djtersteegc/Coco-FujiNet/README.md

Find all the CocoFuji needs in the main Fujinet hardware repo now, https://github.com/FujiNetWIFI/fujinet-hardware
