djtersteegc/Coco-FujiNet/CoCo-FujiNet-Rev000/3D/STL/CoCo-FujiNet-Rev000-Upper.stl

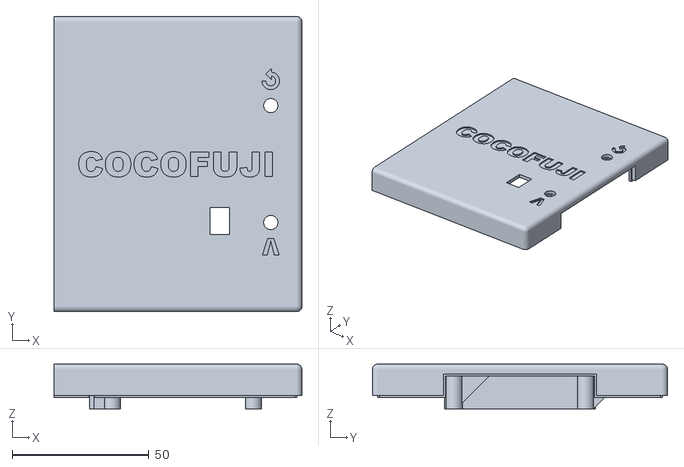
[picture p1: CAD file, 2024-03-17, last stored version]
CoCo-FujiNet-Rev000/3D/STL/CoCo-FujiNet-Rev000-Upper.stl
90.7 x 108.0 x 16.4
