djtersteegc/Coco-FujiNet/CoCo-FujiNet-Rev000/3D/STL/CoCo-FujiNet-Rev000-Lower.stl

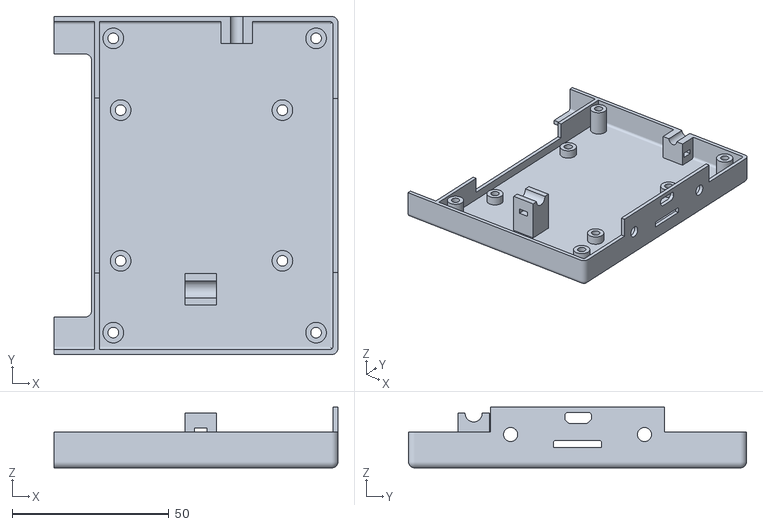
[picture p2: CAD file, 2024-03-17, last stored version]
CoCo-FujiNet-Rev000/3D/STL/CoCo-FujiNet-Rev000-Lower.stl
90.7 x 108.0 x 19.4
