djtersteegc/Coco-FujiNet/CoCo-FujiNet-Rev000/3D/STL/CoCo-FujiNet-Rev000-4mm-Spacer.stl

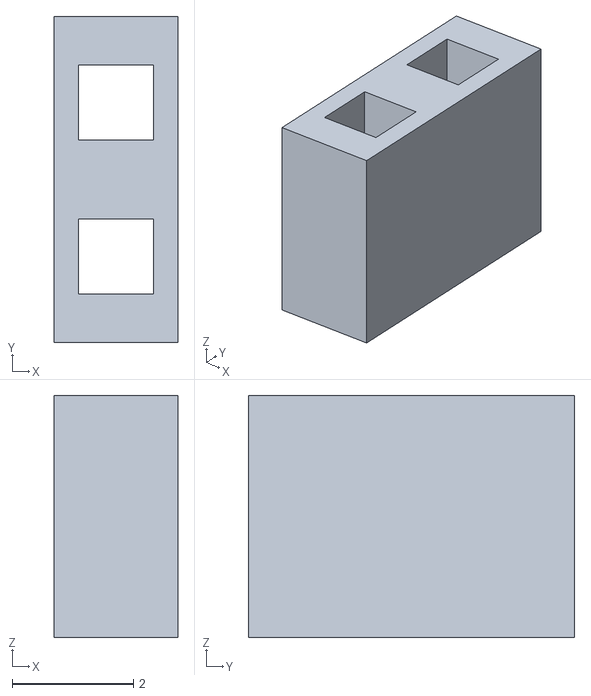
[picture p3: CAD file, 2024-03-04, last stored version]
CoCo-FujiNet-Rev000/3D/STL/CoCo-FujiNet-Rev000-4mm-Spacer.stl
2.04 x 5.38 x 4.00
