djtersteegc/Coco-FujiNet/CoCo-FujiNet-Rev000/CoCo-FujiNet-Rev000.kicad_pcb

## KiCad design CoCo-FujiNet-Rev000/CoCo-FujiNet-Rev000.kicad_pcb (2024-03-04, last stored version)

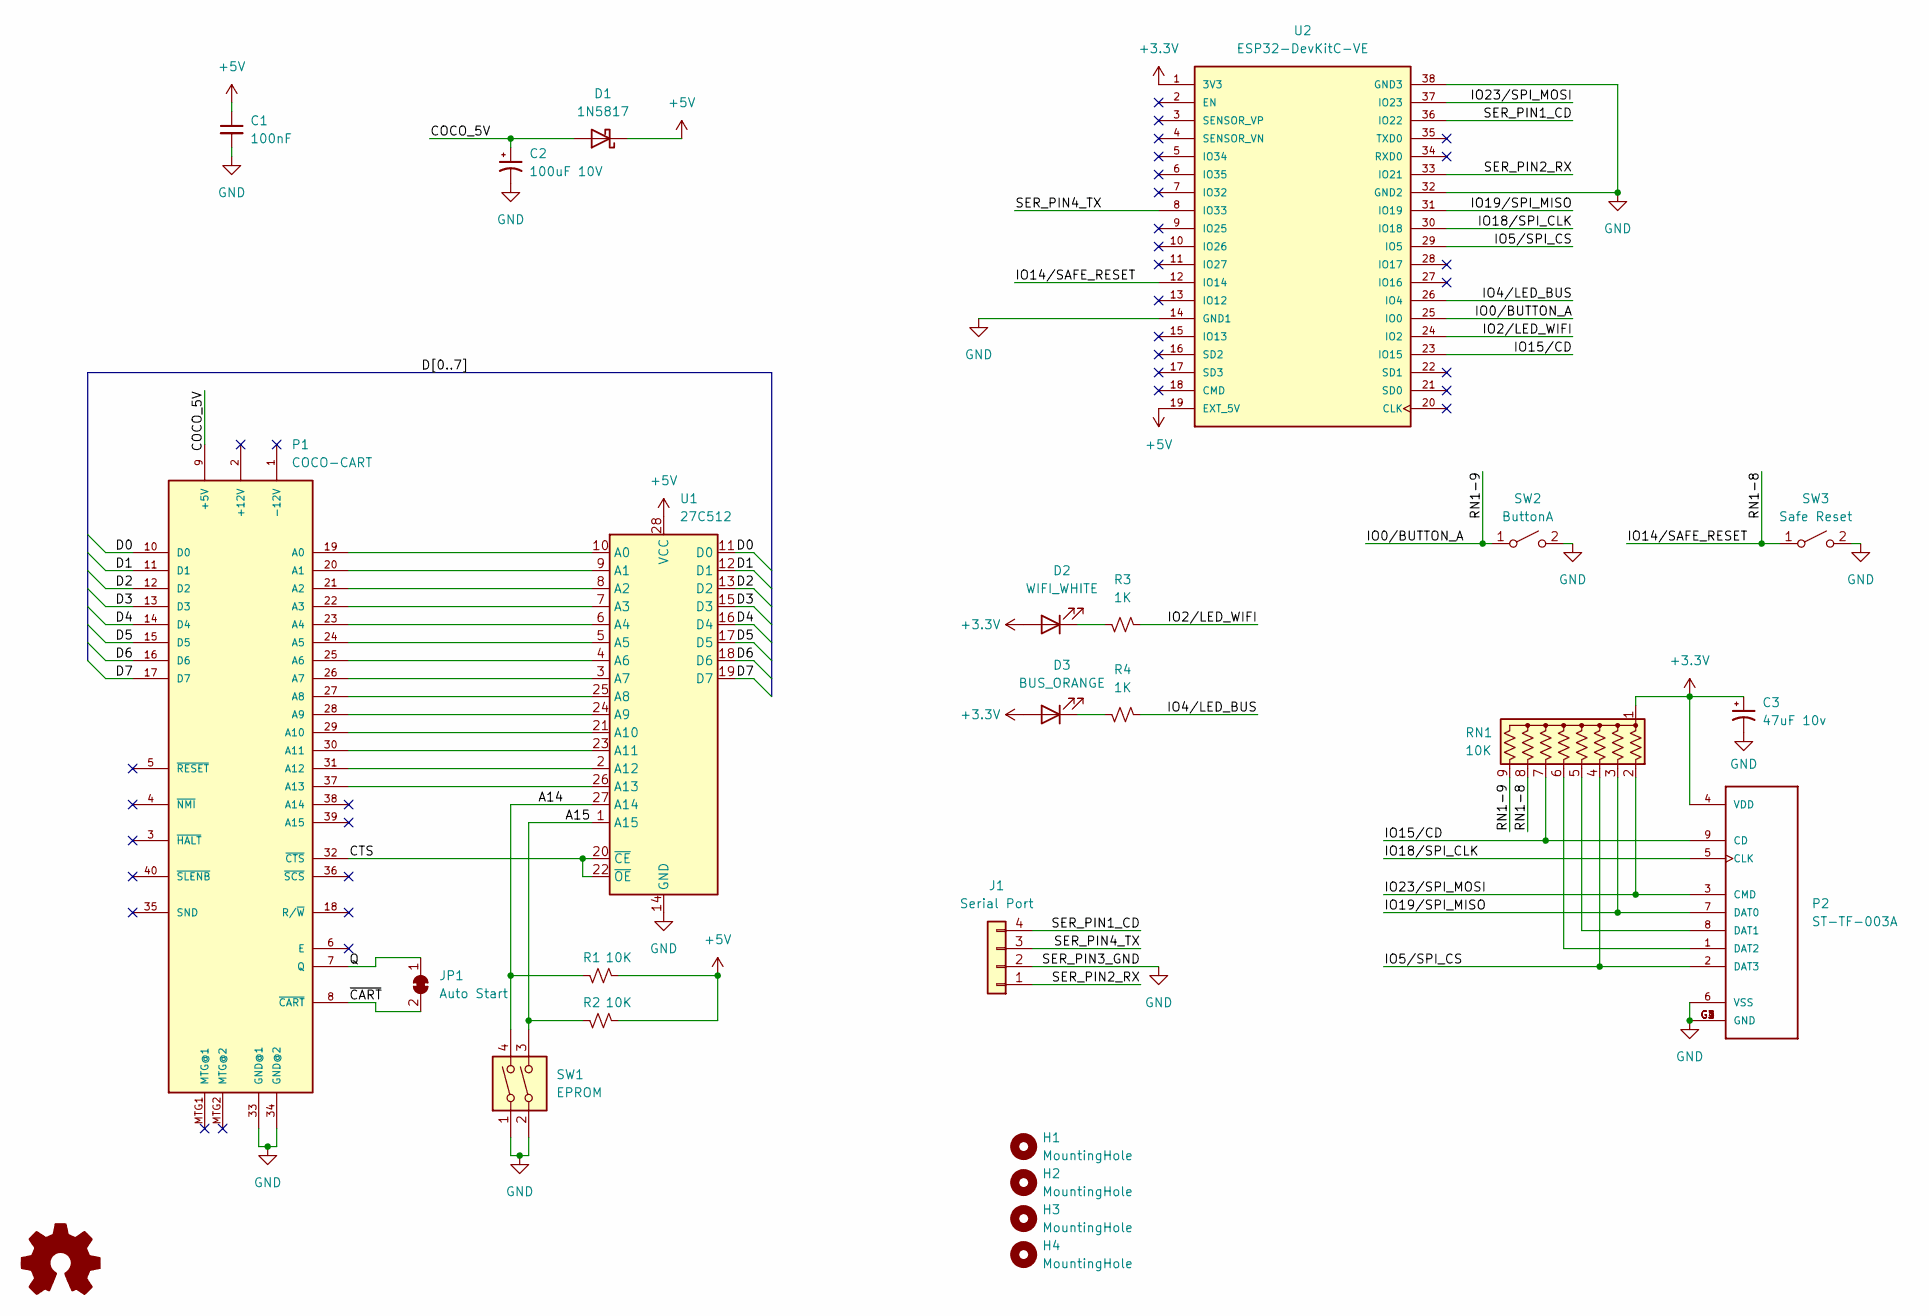
[picture p4: schematic CoCo-FujiNet-Rev000.kicad_sch, CoCo FujiNet]

Parts:
C1: 100nF; C_Disc_D4.7mm_W2.5mm_P5.00mm
C2: 100uF 10V; CP_Radial_D6.3mm_P2.50mm
C3: 47uF 10v; CP_EIA-3528-15_AVX-H_Pad1.50x2.35mm_HandSolder
D1: 1N5817; D_DO-41_SOD81_P10.16mm_Horizontal
D2: WIFI_WHITE; LED_D3.0mm
D3: BUS_ORANGE; LED_D3.0mm
H1, H2, H3, H4: MountingHole; MountingHole_3.2mm_M3
J1: Serial Port; PinHeader_1x04_P2.54mm_Vertical
JP1: Auto Start; SolderJumper-2_P1.3mm_Bridged_RoundedPad1.0x1.5mm
P1: COCO-CART
P2: ST-TF-003A; SUNTECH_ST-TF-003A
R1, R2: 10K; R_Axial_DIN0207_L6.3mm_D2.5mm_P7.62mm_Horizontal
R3, R4: 1K; R_Axial_DIN0207_L6.3mm_D2.5mm_P7.62mm_Horizontal
RN1: 10K; R_Array_SIP9
SW1: EPROM; SW_DIP_SPSTx02_Slide_9.78x7.26mm_W7.62mm_P2.54mm
SW2: ButtonA; SW_Tactile_SPST_Angled_PTS645Vx58-2LFS
SW3: Safe Reset; SW_Tactile_SPST_Angled_PTS645Vx58-2LFS
U1: 27C512; DIP-28_W15.24mm
U2: ESP32-DevKitC-VE; MODULE_ESP32-DEVKITC-32U; PARTREV N/A

Connections:
+3.3V: C3.1, D2.2 (A), D3.2 (A), P2.4 (VDD), RN1.1 (common), U2.1 (3V3)
+5V: C1.1, D1.1 (K), R1.2, R2.2, U1.28 (VCC), U2.19 (EXT_5V)
/A14: R1.1, SW1.4, U1.27 (A14)
/A15: R2.1, SW1.3, U1.1 (A15)
/COCO_5V: C2.1, D1.2 (A), P1.9 (+5V)
/CTS: P1.32 (~CTS), U1.20 (~CE), U1.22 (~OE)
/D0: P1.10 (D0), U1.11 (D0)
/D1: P1.11 (D1), U1.12 (D1)
/D2: P1.12 (D2), U1.13 (D2)
/D3: P1.13 (D3), U1.15 (D3)
/D4: P1.14 (D4), U1.16 (D4)
/D5: P1.15 (D5), U1.17 (D5)
/D6: P1.16 (D6), U1.18 (D6)
/D7: P1.17 (D7), U1.19 (D7)
/IO0/BUTTON_A: RN1.9 (R8), SW2.1 (A), U2.25 (IO0)
/IO2/LED_WIFI: R3.2, U2.24 (IO2)
/IO4/LED_BUS: R4.2, U2.26 (IO4)
/IO5/SPI_CS: P2.2 (DAT3), RN1.4 (R3), U2.29 (IO5)
/IO14/SAFE_RESET: RN1.8 (R7), SW3.1 (A), U2.12 (IO14)
/IO15/CD: P2.9 (CD), RN1.7 (R6), U2.23 (IO15)
/IO18/SPI_CLK: P2.5 (CLK), U2.30 (IO18)
/IO19/SPI_MISO: P2.7 (DAT0), RN1.3 (R2), U2.31 (IO19)
/IO23/SPI_MOSI: P2.3 (CMD), RN1.2 (R1), U2.37 (IO23)
/Q: JP1.1 (A), P1.7 (Q)
/SER_PIN1_CD: J1.4, U2.36 (IO22)
/SER_PIN2_RX: J1.1, U2.33 (IO21)
/SER_PIN4_TX: J1.3, U2.8 (IO33)
/~CART: JP1.2 (B), P1.8 (~CART)
GND: C1.2, C2.2, C3.2, J1.2, P1.33 (GND@1), P1.34 (GND@2), P2.6 (VSS), P2.G1 (GND), P2.G2 (GND), P2.G3 (GND), P2.G4 (GND), SW1.1, SW1.2, SW2.2 (B), SW3.2 (B), U1.14 (GND), U2.14 (GND1), U2.32 (GND2), U2.38 (GND3)
unnamed: D2.1 (K), R3.1
unnamed: D3.1 (K), R4.1
unnamed: P1.19 (A0), U1.10 (A0)
unnamed: P1.20 (A1), U1.9 (A1)
unnamed: P1.21 (A2), U1.8 (A2)
unnamed: P1.22 (A3), U1.7 (A3)
unnamed: P1.23 (A4), U1.6 (A4)
unnamed: P1.24 (A5), U1.5 (A5)
unnamed: P1.25 (A6), U1.4 (A6)
unnamed: P1.26 (A7), U1.3 (A7)
unnamed: P1.27 (A8), U1.25 (A8)
unnamed: P1.28 (A9), U1.24 (A9)
unnamed: P1.29 (A10), U1.21 (A10)
unnamed: P1.30 (A11), U1.23 (A11)
unnamed: P1.31 (A12), U1.2 (A12)
unnamed: P1.37 (A13), U1.26 (A13)
unnamed: P2.8 (DAT1), RN1.5 (R4)
unnamed: P2.1 (DAT2), RN1.6 (R5)

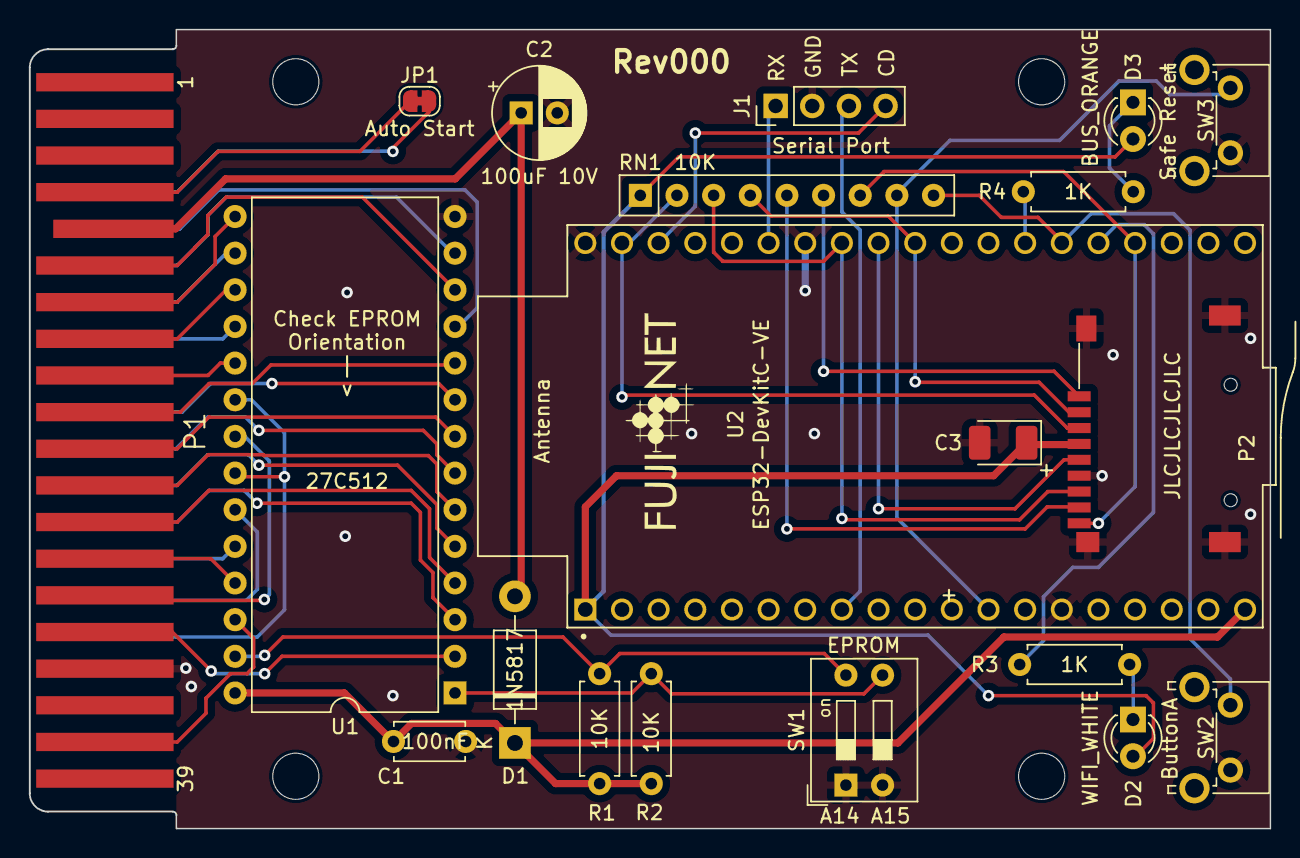
[picture p5: board CoCo-FujiNet-Rev000.kicad_pcb from above]

Board: 2 copper layers, 86.0 x 55.4 mm, 24 parts (0 on the bottom side), 47 nets.
