djtersteegc/Coco-FujiNet/CoCo-FujiNet-Rev00/CoCo-FujiNet-Rev00.kicad_pcb

## KiCad design CoCo-FujiNet-Rev00/CoCo-FujiNet-Rev00.kicad_pcb (2024-01-20, last stored version)

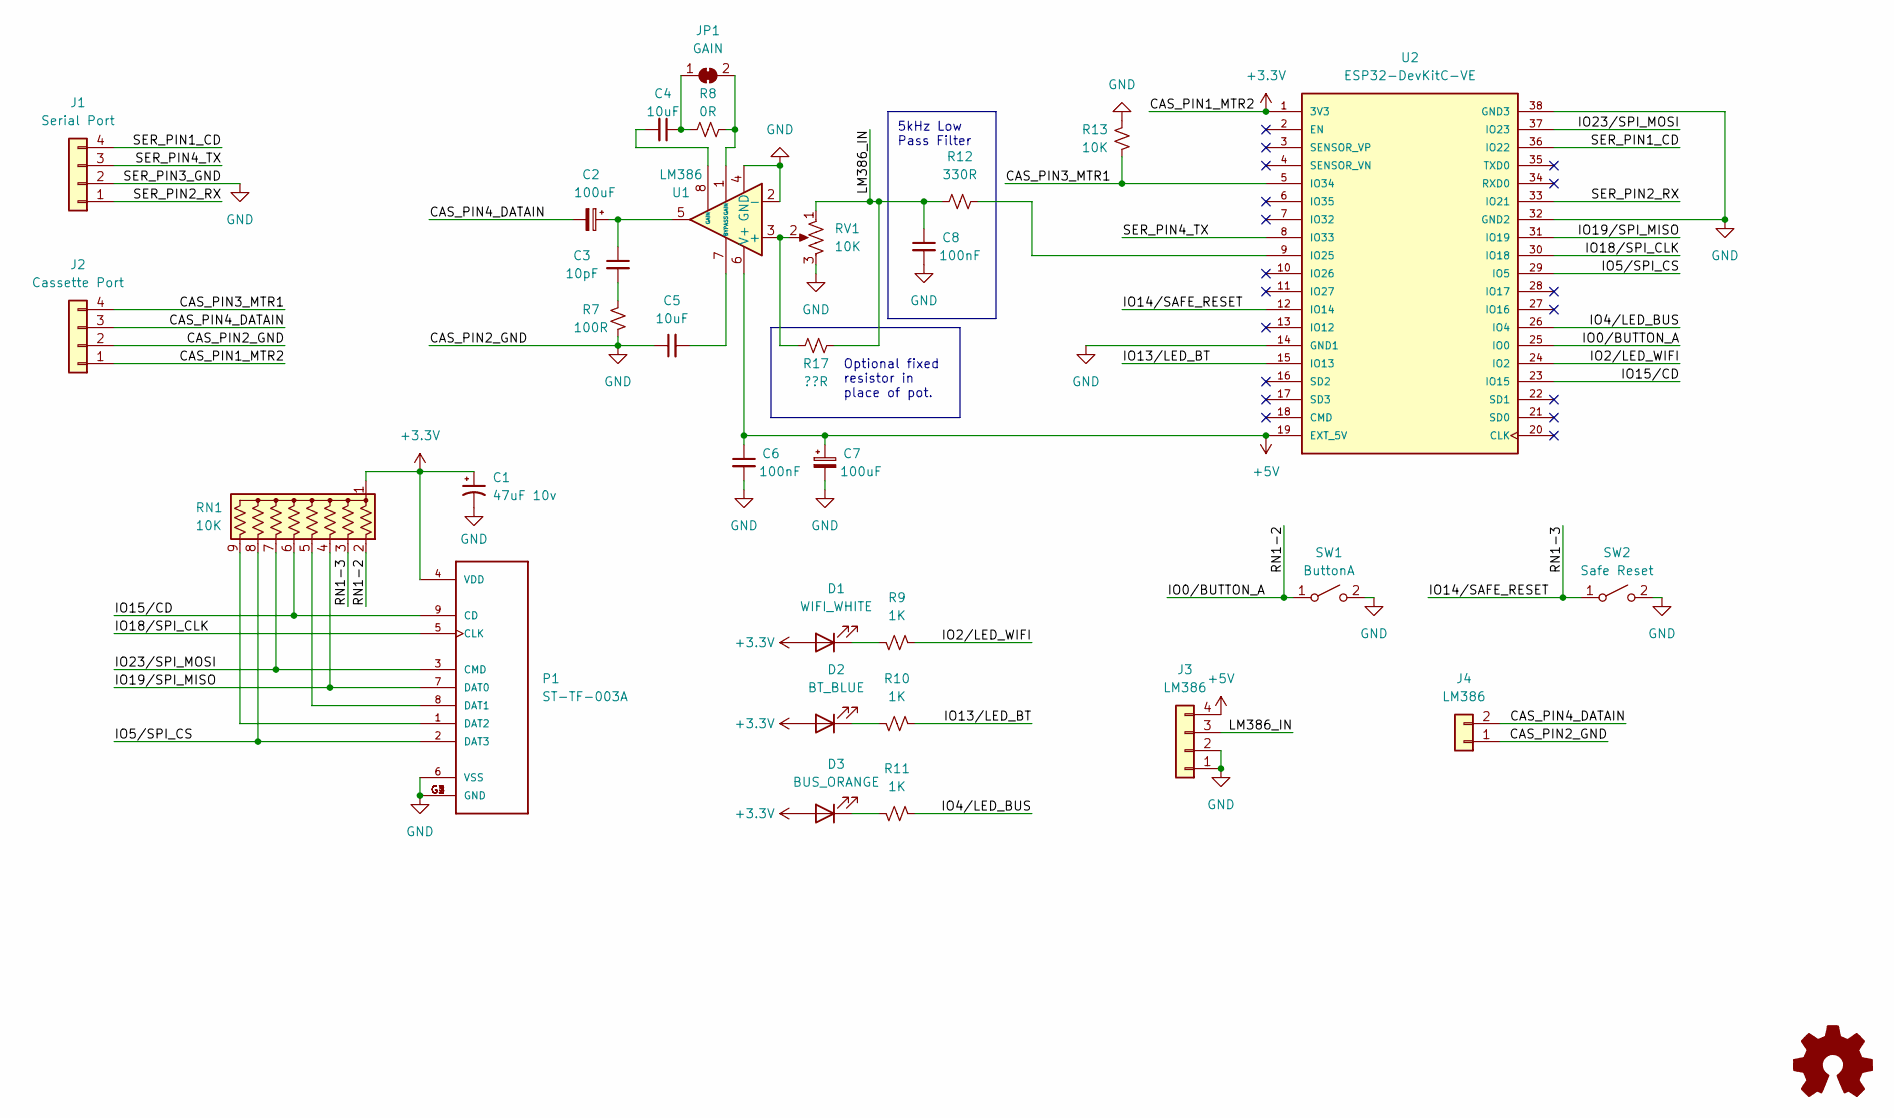
[picture p6: schematic CoCo-FujiNet-Rev00.kicad_sch, CoCo FujiNet]

Parts:
C1: 47uF 10v; CP_EIA-3528-15_AVX-H_Pad1.50x2.35mm_HandSolder
C2, C7: 100uF; CP_Radial_D6.3mm_P2.50mm
C3: 10pF; C_Disc_D5.0mm_W2.5mm_P5.00mm
C4, C5: 10uF; C_Disc_D5.0mm_W2.5mm_P5.00mm
C6, C8: 100nF; C_Disc_D5.0mm_W2.5mm_P5.00mm
D1: WIFI_WHITE; LED_D3.0mm
D2: BT_BLUE; LED_D3.0mm
D3: BUS_ORANGE; LED_D3.0mm
J1: Serial Port; PinHeader_1x04_P2.54mm_Vertical
J2: Cassette Port; PinHeader_1x04_P2.54mm_Vertical
J3: LM386; PinHeader_1x04_P2.54mm_Vertical
J4: LM386; PinHeader_1x02_P2.54mm_Vertical
JP1: GAIN; SolderJumper-2_P1.3mm_Bridged_RoundedPad1.0x1.5mm
P1: ST-TF-003A; SUNTECH_ST-TF-003A
R7: 100R; R_Axial_DIN0207_L6.3mm_D2.5mm_P7.62mm_Horizontal
R8: 0R; R_Axial_DIN0207_L6.3mm_D2.5mm_P7.62mm_Horizontal
R9, R10, R11: 1K; R_Axial_DIN0207_L6.3mm_D2.5mm_P7.62mm_Horizontal
R12: 330R; R_Axial_DIN0207_L6.3mm_D2.5mm_P7.62mm_Horizontal
R13: 10K; R_Axial_DIN0207_L6.3mm_D2.5mm_P7.62mm_Horizontal
R17: ??R; R_Axial_DIN0207_L6.3mm_D2.5mm_P7.62mm_Horizontal
RN1: 10K; R_Array_SIP9
RV1: 10K; Potentiometer_Runtron_RM-065_Vertical
SW1: ButtonA; SW_PUSH_6mm_H5mm
SW2: Safe Reset; SW_PUSH_6mm_H5mm
U1: LM386; DIP-8_W7.62mm_Socket
U2: ESP32-DevKitC-VE; MODULE_ESP32-DEVKITC-32U; PARTREV N/A

Connections:
+3.3V: C1.1, D1.2 (A), D2.2 (A), D3.2 (A), J2.1, P1.4 (VDD), RN1.1 (common), U2.1 (3V3)
+5V: C6.1, C7.1, J3.4, U1.6 (V+), U2.19 (EXT_5V)
/CAS_PIN3_MTR1: J2.4, R13.1, U2.5 (IO34)
/CAS_PIN4_DATAIN: C2.2, J2.3, J4.2
/IO0/BUTTON_A: RN1.2 (R1), SW1.1 (A), U2.25 (IO0)
/IO2/LED_WIFI: R9.2, U2.24 (IO2)
/IO4/LED_BUS: R11.2, U2.26 (IO4)
/IO5/SPI_CS: P1.2 (DAT3), RN1.8 (R7), U2.29 (IO5)
/IO13/LED_BT: R10.2, U2.15 (IO13)
/IO14/SAFE_RESET: RN1.3 (R2), SW2.1 (A), U2.12 (IO14)
/IO15/CD: P1.9 (CD), RN1.6 (R5), U2.23 (IO15)
/IO18/SPI_CLK: P1.5 (CLK), U2.30 (IO18)
/IO19/SPI_MISO: P1.7 (DAT0), RN1.4 (R3), U2.31 (IO19)
/IO23/SPI_MOSI: P1.3 (CMD), RN1.7 (R6), U2.37 (IO23)
/LM386_IN: C8.1, J3.3, R12.1, R17.2, RV1.1
/SER_PIN1_CD: J1.4, U2.36 (IO22)
/SER_PIN2_RX: J1.1, U2.33 (IO21)
/SER_PIN4_TX: J1.3, U2.8 (IO33)
GND: C1.2, C5.1, C6.2, C7.2, C8.2, J1.2, J2.2, J3.1, J3.2, J4.1, P1.6 (VSS), P1.G1 (GND), P1.G2 (GND), P1.G3 (GND), P1.G4 (GND), R7.1, R13.2, RV1.3, SW1.2 (B), SW2.2 (B), U1.2 (-), U1.4 (GND), U2.14 (GND1), U2.32 (GND2), U2.38 (GND3)
unnamed: C2.1, C3.1, U1.5
unnamed: C3.2, R7.2
unnamed: C4.2, U1.8 (GAIN)
unnamed: D1.1 (K), R9.1
unnamed: D2.1 (K), R10.1
unnamed: D3.1 (K), R11.1
unnamed: C4.1, JP1.1 (A), R8.1
unnamed: JP1.2 (B), R8.2, U1.1 (GAIN)
unnamed: P1.8 (DAT1), RN1.5 (R4)
unnamed: P1.1 (DAT2), RN1.9 (R8)
unnamed: R17.1, RV1.2, U1.3 (+)
unnamed: C5.2, U1.7 (BYPASS)
unnamed: R12.2, U2.9 (IO25)

Notes on the sheet:
5kHz Low Pass Filter
Optional fixed resistor in place of pot.

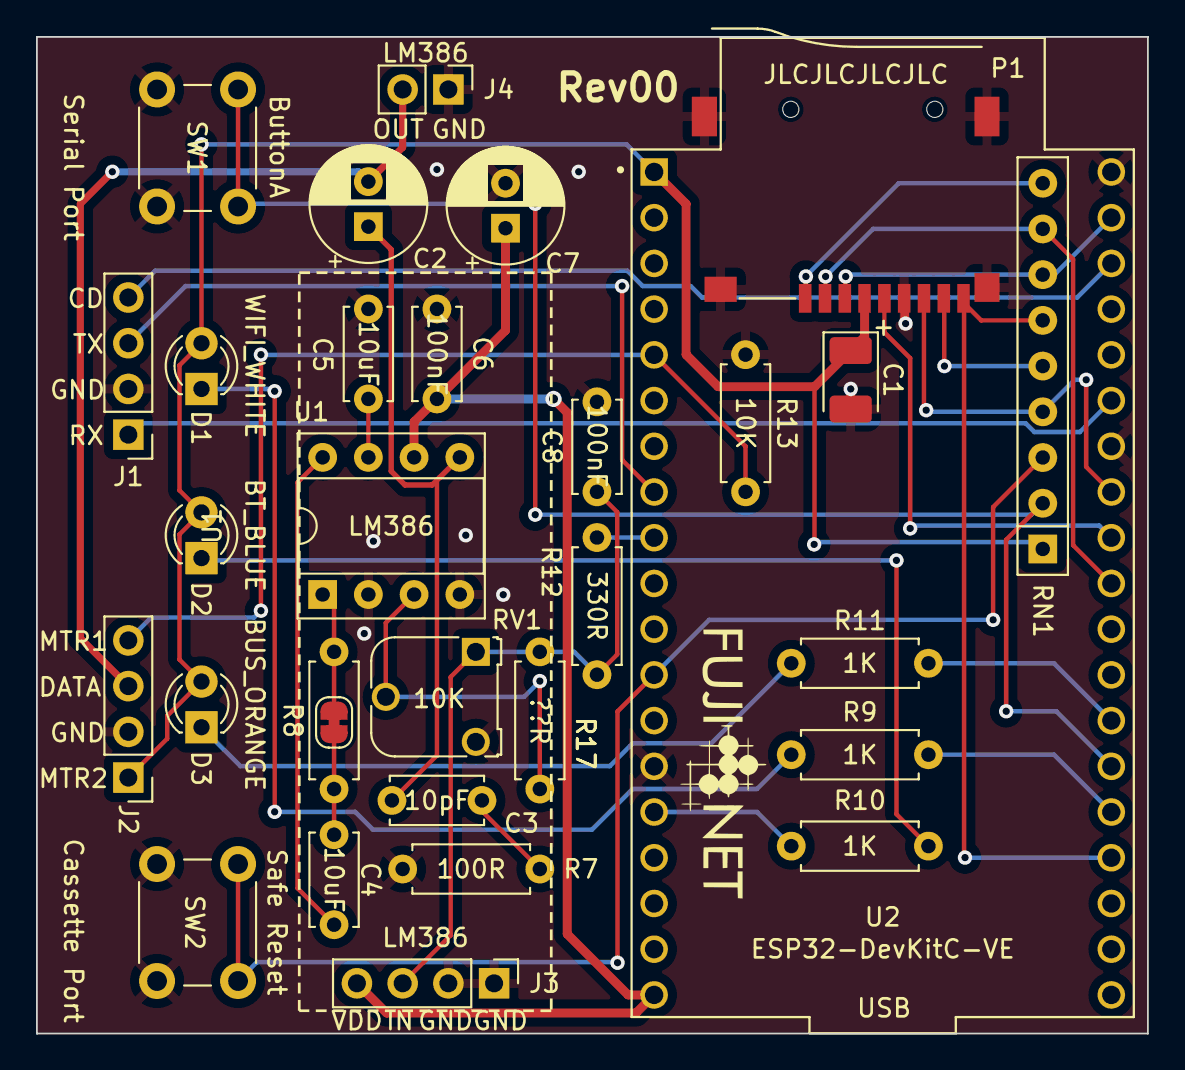
[picture p7: board CoCo-FujiNet-Rev00.kicad_pcb from above]

Board: 2 copper layers, 61.7 x 55.4 mm, 31 parts (0 on the bottom side), 32 nets.
