djtersteegc/Coco-FujiNet/(commit log)

2024-01-12 Rev0 sent to JLC
    [CoCo-FujiNet-Rev0-B_Cu.gbr, CoCo-FujiNet-Rev0-B_Mask.gbr, CoCo-FujiNet-Rev0-B_Paste.gbr, CoCo-FujiNet-Rev0-B_Silkscreen.gbr, CoCo-FujiNet-Rev0-Edge_Cuts.gbr, CoCo-FujiNet-Rev0-F_Cu.gbr, CoCo-FujiNet-Rev0-F_Mask.gbr, CoCo-FujiNet-Rev0-F_Paste.gbr]
2024-01-20 Add Rev00
    [CoCo-FujiNet-Rev00-B_Cu.gbr, CoCo-FujiNet-Rev00-B_Mask.gbr, CoCo-FujiNet-Rev00-B_Paste.gbr, CoCo-FujiNet-Rev00-B_Silkscreen.gbr, CoCo-FujiNet-Rev00-Edge_Cuts.gbr, CoCo-FujiNet-Rev00-F_Cu.gbr, CoCo-FujiNet-Rev00-F_Mask.gbr, CoCo-FujiNet-Rev00-F_Paste.gbr]
2024-01-20 Add some Rev00 docs
    [CoCo-FujiNet-Rev00.kicad_pcb, CoCo-FujiNet-Rev00.kicad_sch]
2024-01-25 Add KiCad PCB image
2024-03-04 Add Rev000 files and update docs
    [CoCo-FujiNet-Rev000-4mm-Spacer.stl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]
2024-03-17 Update 3D files and docs for VIE antenna option
    [CoCo-FujiNet-Rev000-Lower.stl, CoCo-FujiNet-Rev000-Upper.stl]
2025-02-03 Remove and redirect to Fujinet hardware repo
    [CoCo-FujiNet-Rev0-B_Cu.gbr, CoCo-FujiNet-Rev0-B_Mask.gbr, CoCo-FujiNet-Rev0-B_Paste.gbr, CoCo-FujiNet-Rev0-B_Silkscreen.gbr, CoCo-FujiNet-Rev0-Edge_Cuts.gbr, CoCo-FujiNet-Rev0-F_Cu.gbr, CoCo-FujiNet-Rev0-F_Mask.gbr, CoCo-FujiNet-Rev0-F_Paste.gbr]
